KarlZeilhofer/htl-netzteil/screenshots/2019-12-21_009.png

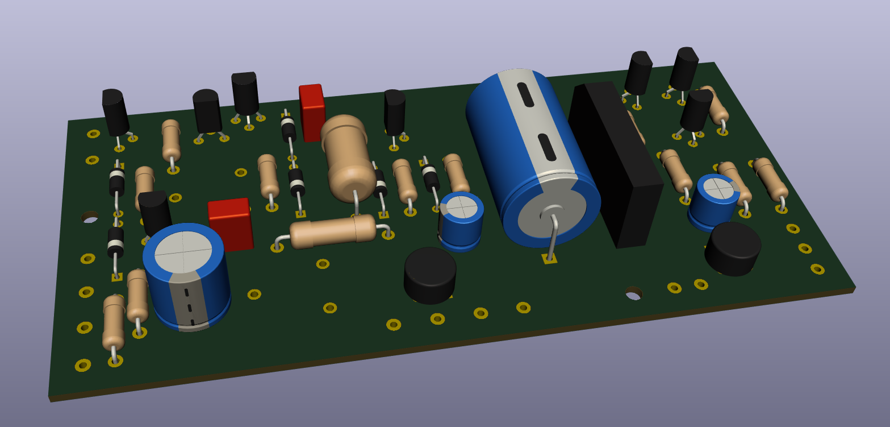
screenshots/2019-12-21_009.png
