KarlZeilhofer/htl-netzteil/screenshots/2019-12-21_006.png

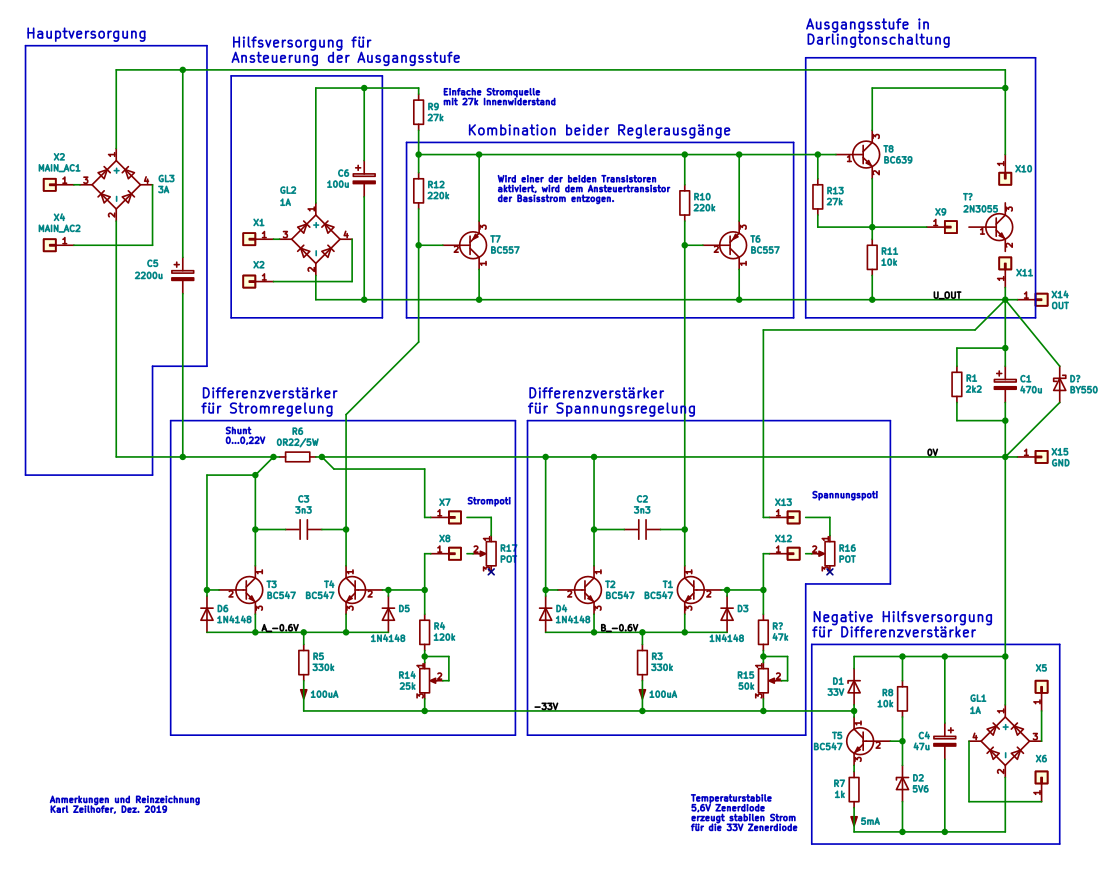
screenshots/2019-12-21_006.png
