KarlZeilhofer/htl-netzteil/screenshots/2019-12-21_007.png

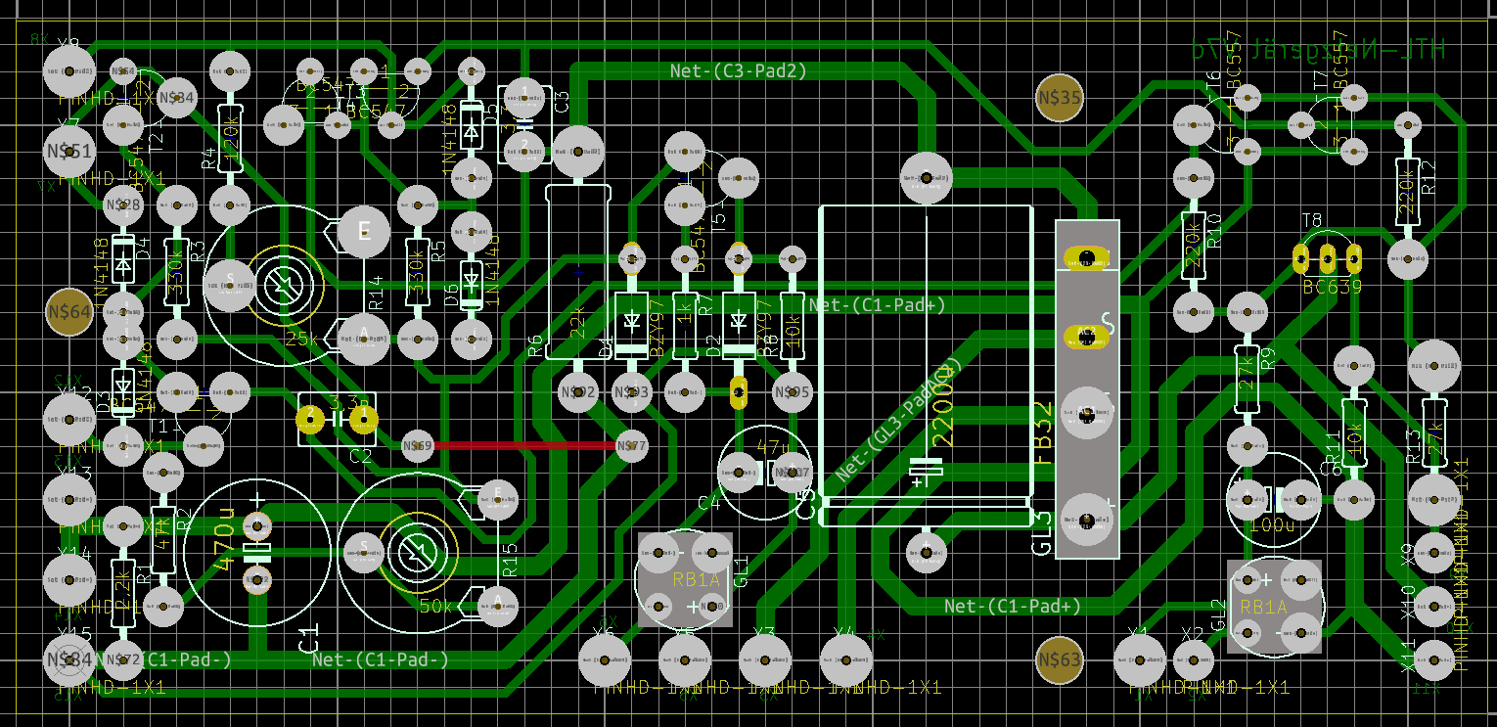
screenshots/2019-12-21_007.png
