KarlZeilhofer/htl-netzteil/screenshots/2019-12-21_010.png

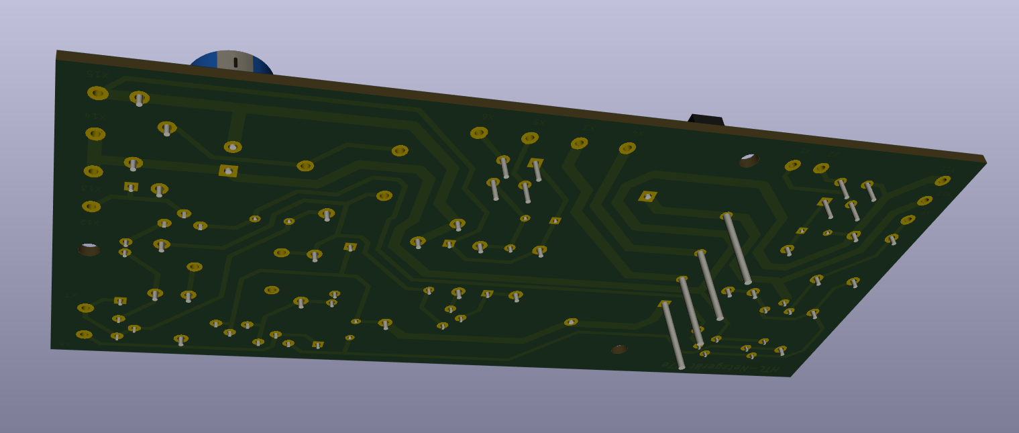
screenshots/2019-12-21_010.png
