KarlZeilhofer/htl-netzteil/screenshots/2019-12-21_011.png

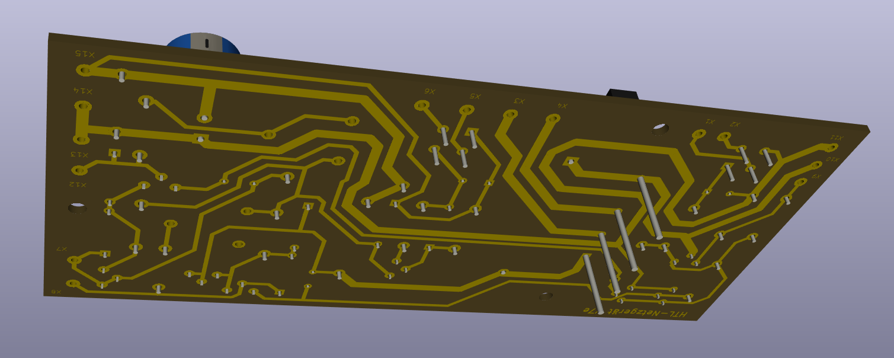
screenshots/2019-12-21_011.png
