KarlZeilhofer/htl-netzteil/screenshots/2020-11-19_003.png

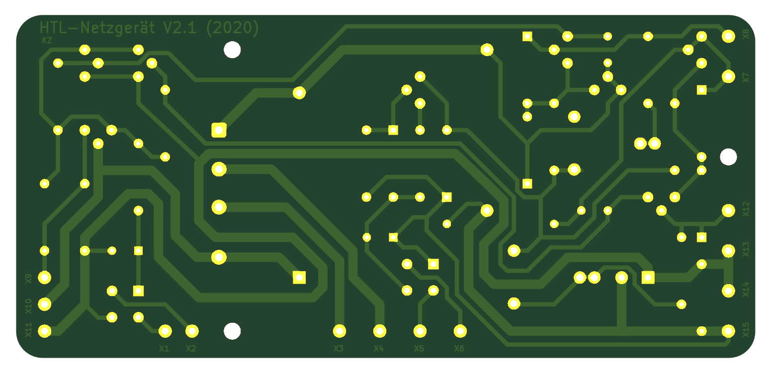
screenshots/2020-11-19_003.png
