KarlZeilhofer/htl-netzteil/screenshots/2020-11-19_005.png

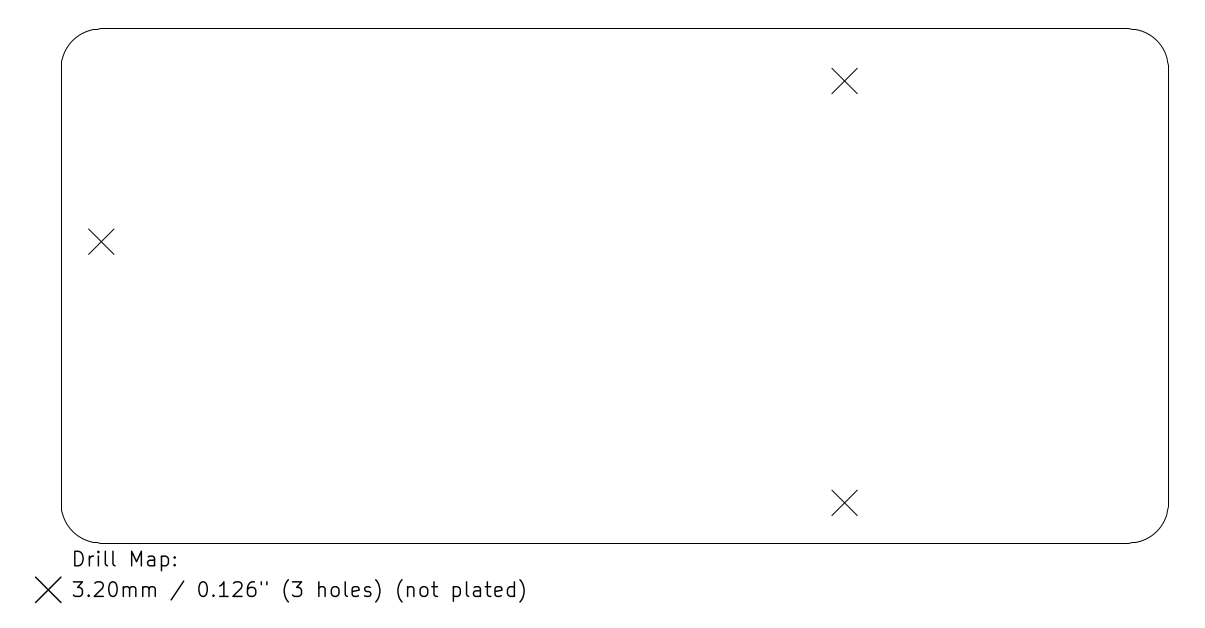
screenshots/2020-11-19_005.png
