KarlZeilhofer/htl-netzteil/screenshots/2020-11-19_006.png

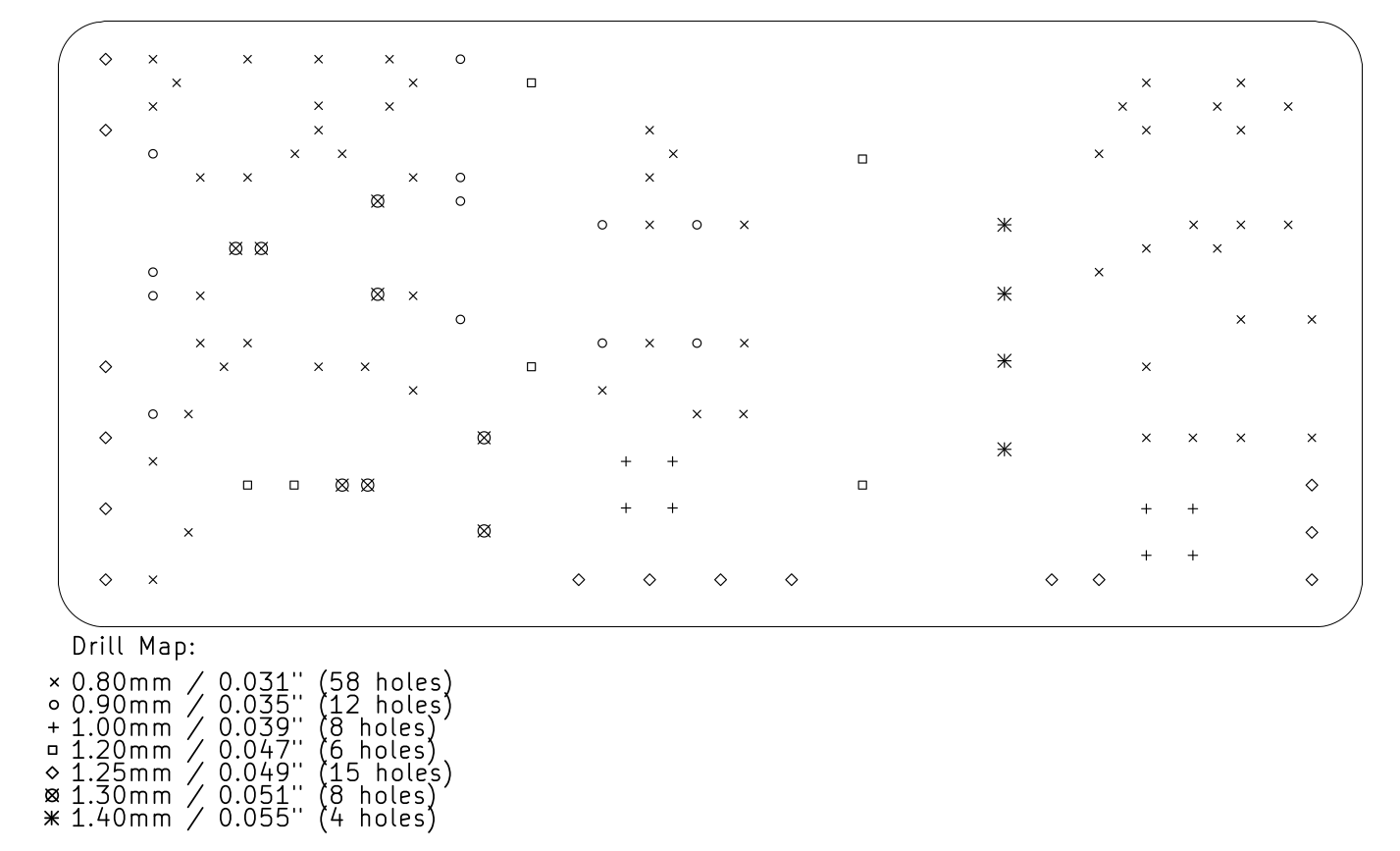
screenshots/2020-11-19_006.png
