KarlZeilhofer/htl-netzteil/screenshots/2020-11-19_007.png

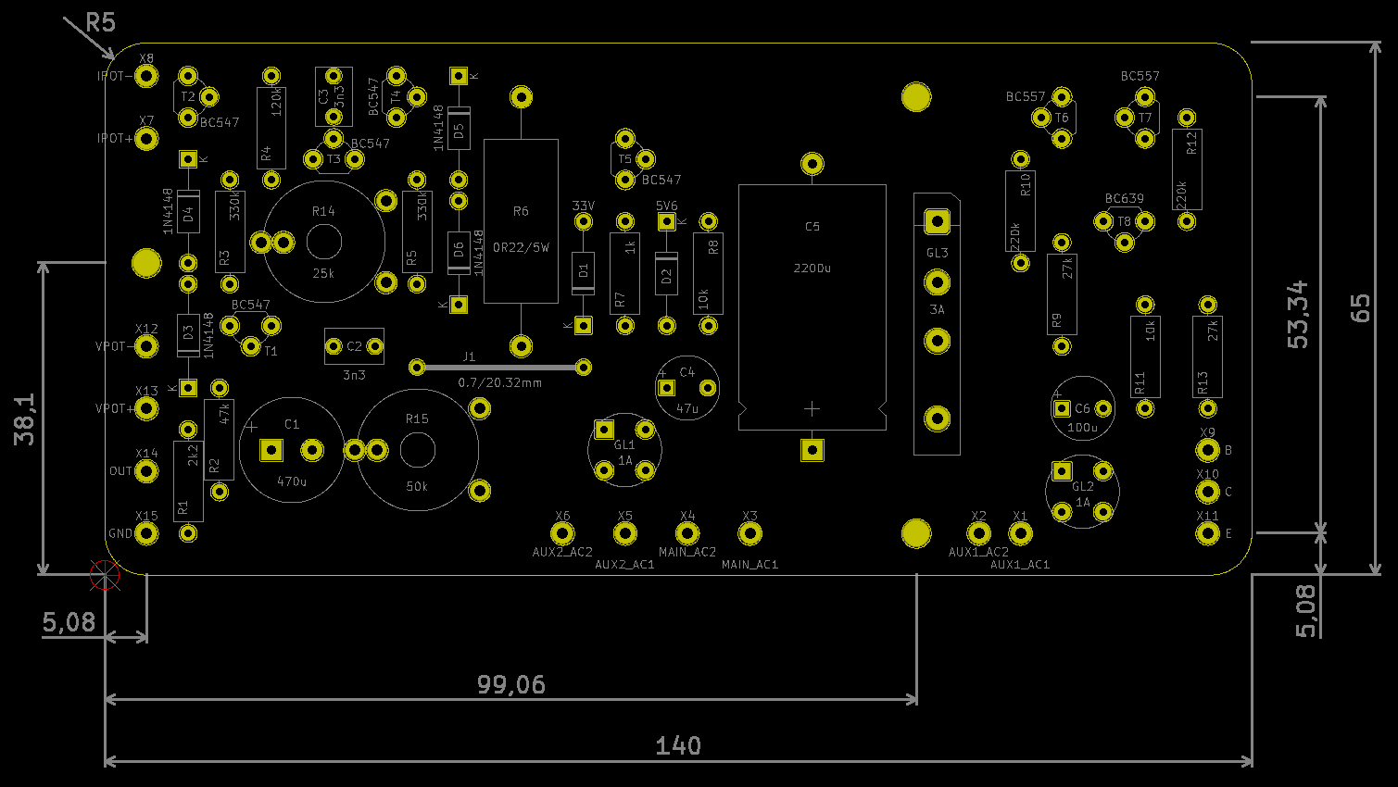
screenshots/2020-11-19_007.png
