KarlZeilhofer/htl-netzteil/screenshots/2020-11-19_008.png

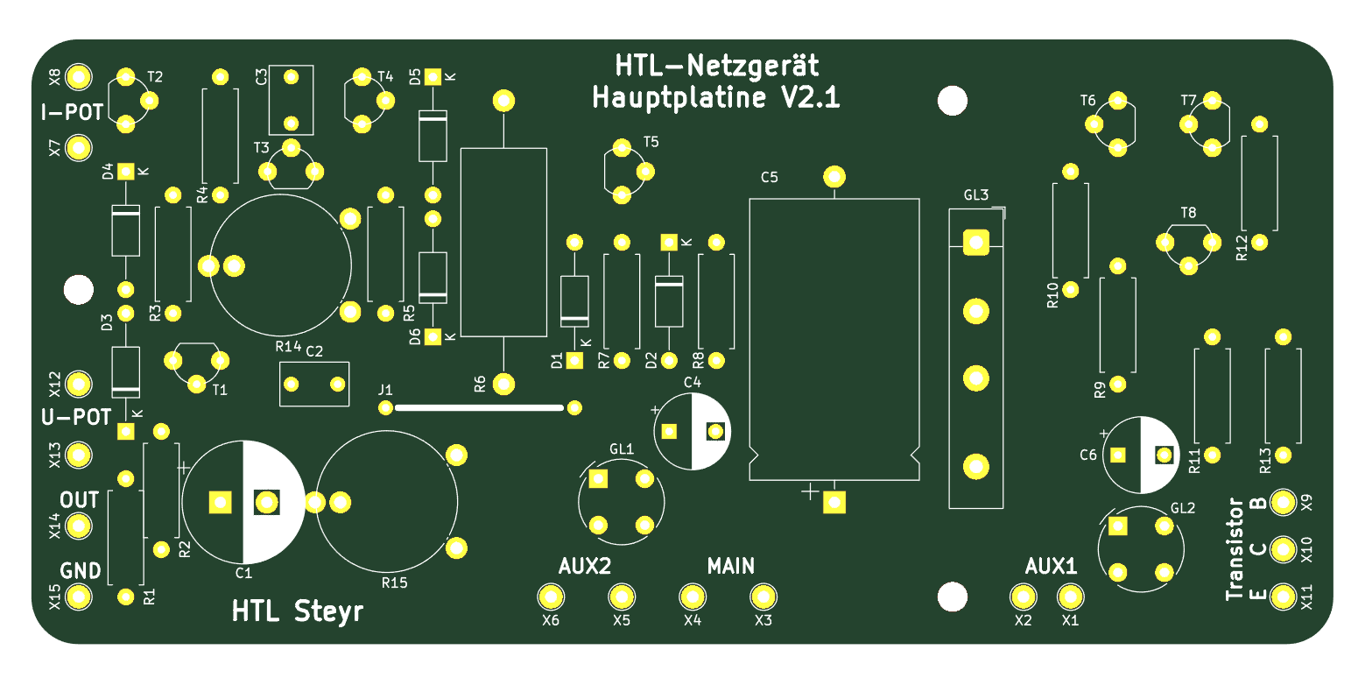
screenshots/2020-11-19_008.png
