KarlZeilhofer/htl-netzteil/screenshots/2020-11-19_010.png

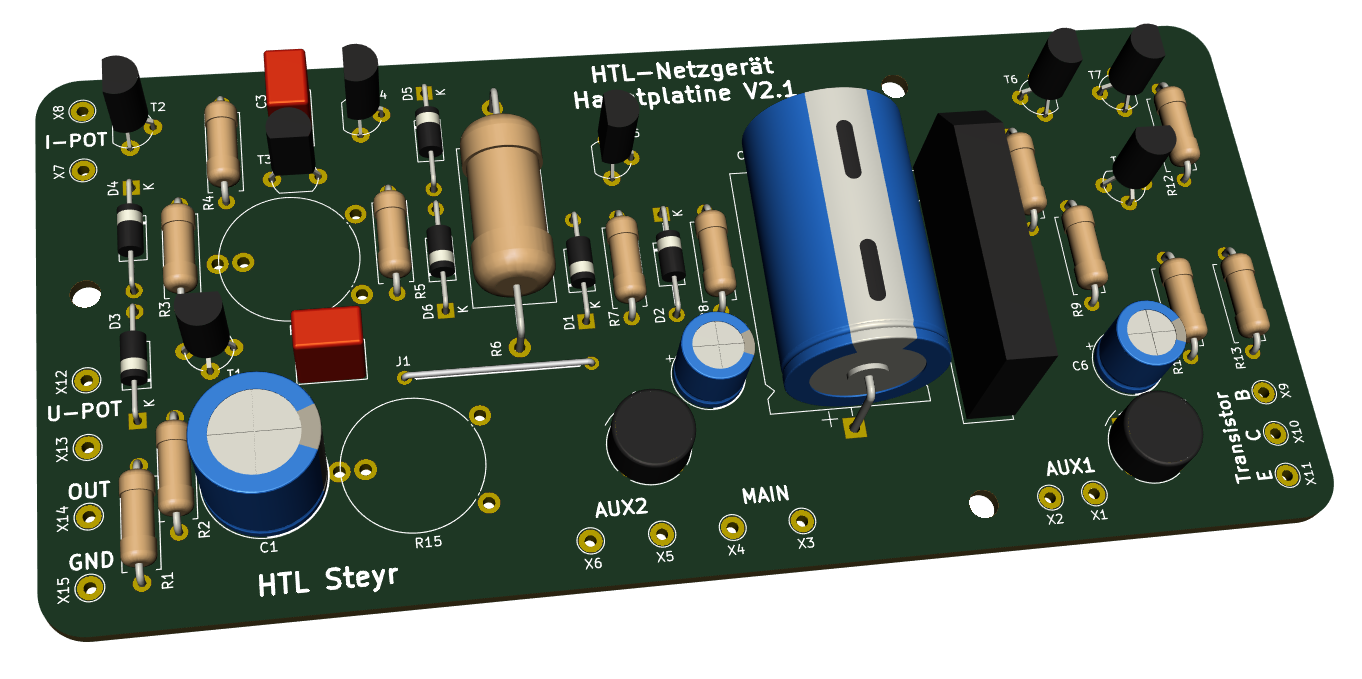
screenshots/2020-11-19_010.png
