KarlZeilhofer/htl-netzteil/screenshots/2020-11-20_001.png

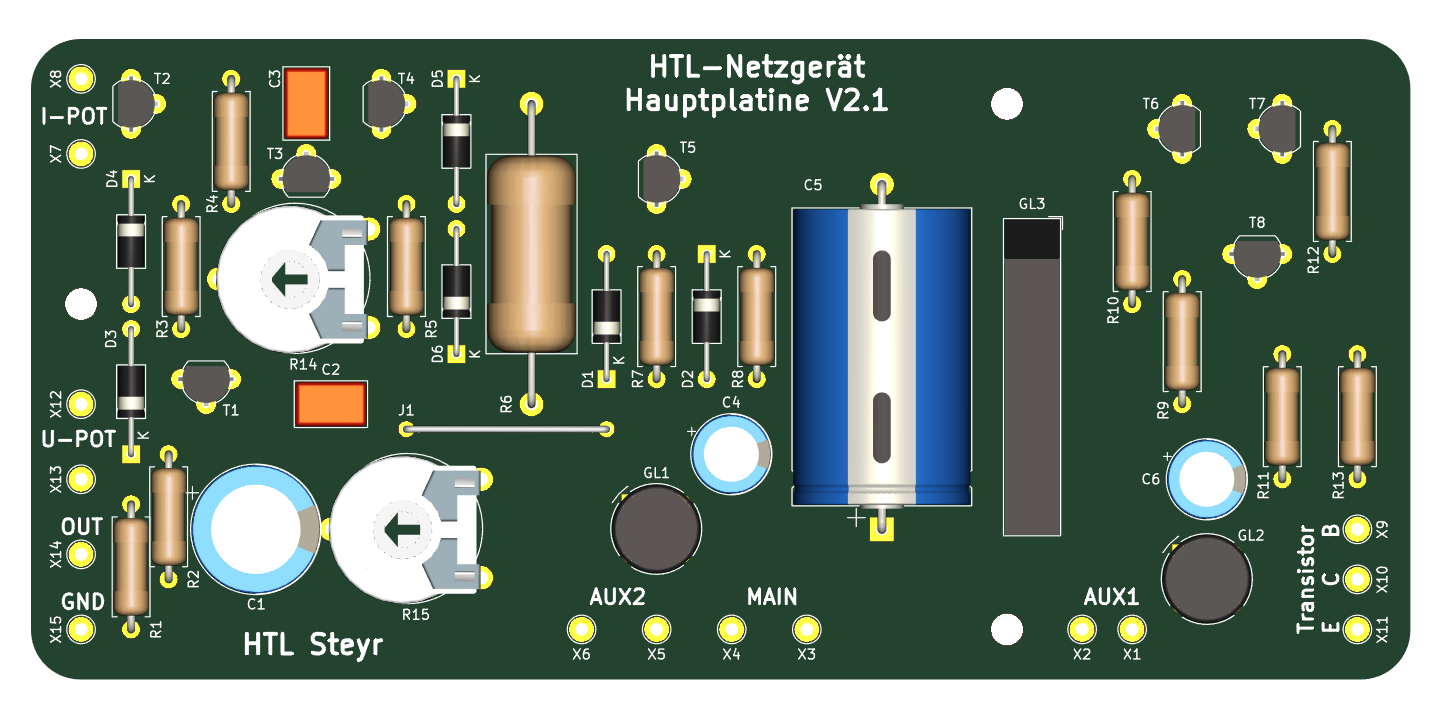
screenshots/2020-11-20_001.png
