KarlZeilhofer/htl-netzteil/sch/HTL Netzgerät bw.pdf

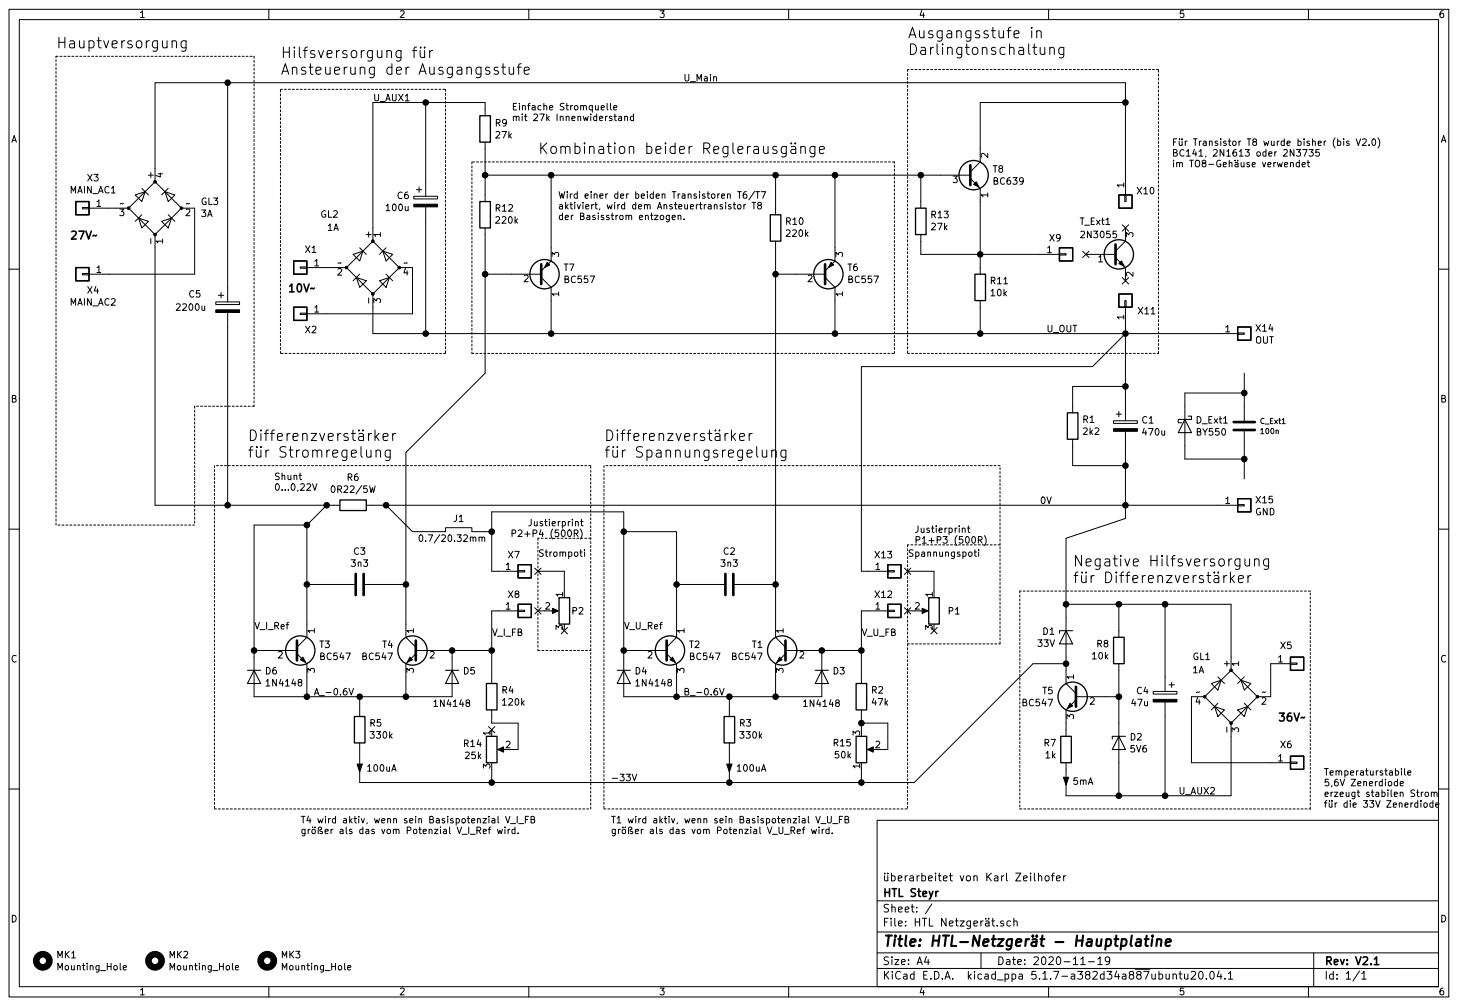
[picture p13: page 1]

Für Transistor T8 wurde bisher (bis V2.0) BC141, 2N1613 oder 2N3735

aktiviert, wird dem Ansteuertransistor T8
der Basisstrom entzogen.

Justierprint P2+P4 (500R)

Justierprint P1+P3 (500R)

T4 wird aktiv, wenn sein Basispotenzial V_I_FB
größer als das vom Potenzial V_I_Ref wird.

T1 wird aktiv, wenn sein Basispotenzial V_U_FB
größer als das vom Potenzial V_U_Ref wird.

Id: 1/1 Title: HTL-Netzgerät - Hauptplatine
