KarlZeilhofer/htl-netzteil/fab/HTL Netzgerät-F_Fab.pdf

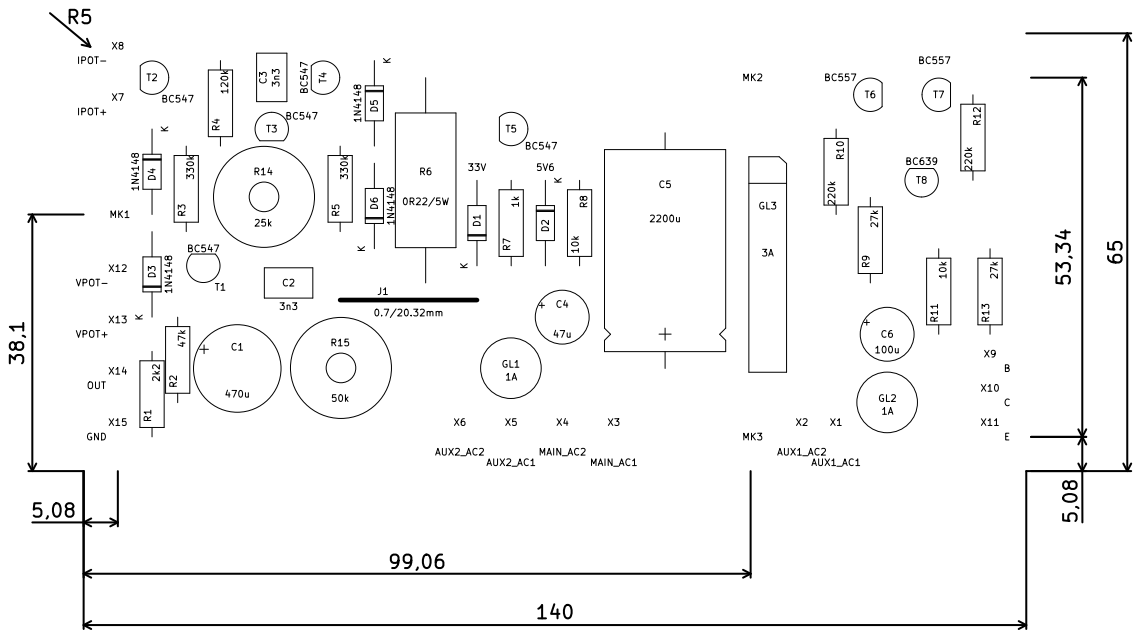
[picture p14: page 1]
