KarlZeilhofer/htl-netzteil/HTL Netzgerät.kicad_pcb

## KiCad design HTL Netzgerät.kicad_pcb (2021-04-29)

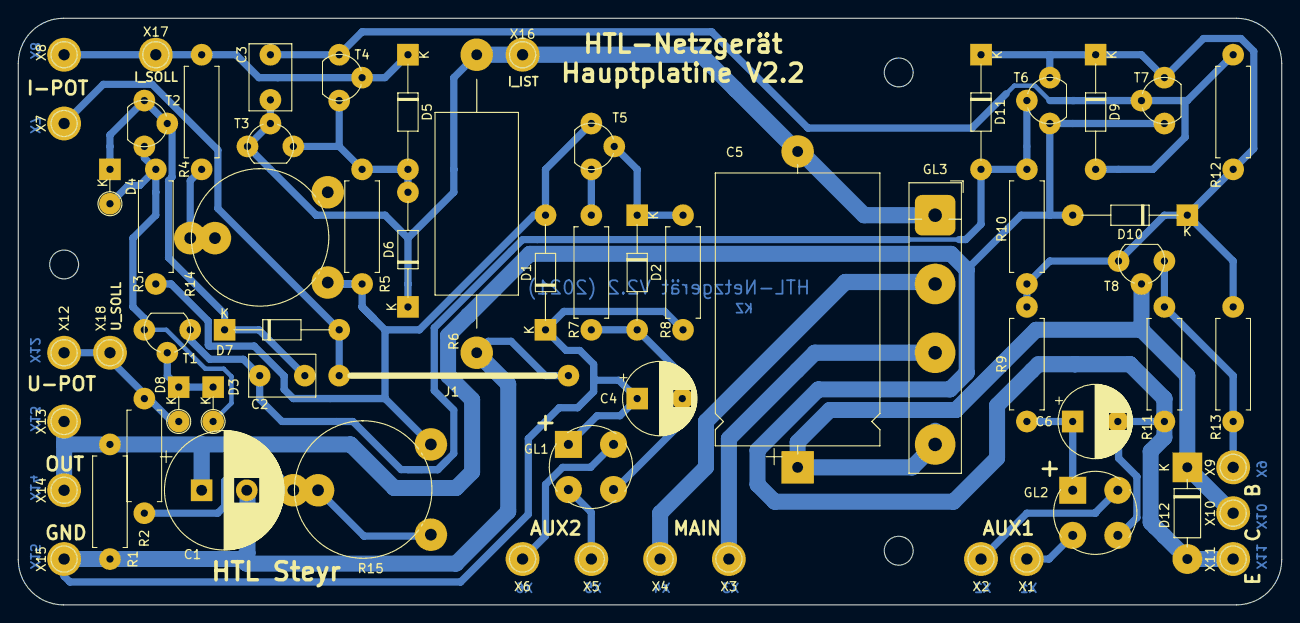
[picture p15: board HTL Netzgerät.kicad_pcb from above]

Board: 2 copper layers, 140.0 x 65.0 mm, 66 parts (0 on the bottom side), 28 nets.

Parts:
C1: 470u; CP_Radial_D13.0mm_P5.00mm
C2, C3: 3n3; C_Rect_L7.2mm_W4.5mm_P5.00mm_FKS2_FKP2_MKS2_MKP2
C4: 47u; CP_Radial_D8.0mm_P5.00mm
C5: 2200u; CP_Axial_L30.0mm_D18.0mm_P35.00mm_Horizontal
C6: 100u; CP_Radial_D8.0mm_P5.00mm
D1: 33V; D_DO-35_SOD27_P12.70mm_Horizontal
D2: 5V6; D_DO-35_SOD27_P12.70mm_Horizontal
D3, D4, D8: 1N4148; D_DO-35_SOD27_P3.81mm_Vertical_KathodeUp
D5, D6, D7, D9, D10, D11: 1N4148; D_DO-35_SOD27_P12.70mm_Horizontal
D12: 1N4007; D_DO-41_SOD81_P10.16mm_Horizontal
GL1, GL2: 1A; Diode_Bridge_Round_D9.0mm
GL3: 3A; Brueckengleichrichter_p7.4-7.2-9.5mm
J1: 0.7/25.4mm; Drahtbruecke_d0.7mm_P20.32mm
MK1, MK2, MK3: Mounting_Hole; MountingHole_3.2mm_M3
R1: 2k2; R_Axial_DIN0411_L9.9mm_D3.6mm_P12.70mm_Horizontal
R2: 47k; R_Axial_DIN0411_L9.9mm_D3.6mm_P12.70mm_Horizontal
R3, R5: 330k; R_Axial_DIN0411_L9.9mm_D3.6mm_P12.70mm_Horizontal
R4: 120k; R_Axial_DIN0411_L9.9mm_D3.6mm_P12.70mm_Horizontal
R6: 0R22/5W; R_Axial_DIN0922_L20.0mm_D9.0mm_P30.48mm_Horizontal
R7: 1k; R_Axial_DIN0411_L9.9mm_D3.6mm_P12.70mm_Horizontal
R8, R11: 10k; R_Axial_DIN0411_L9.9mm_D3.6mm_P12.70mm_Horizontal
R9, R13: 27k; R_Axial_DIN0411_L9.9mm_D3.6mm_P12.70mm_Horizontal
R10, R12: 220k; R_Axial_DIN0411_L9.9mm_D3.6mm_P12.70mm_Horizontal
R14: 25k; Potentiometer_Piher_PT-15-V02_Vertical
R15: 50k; Potentiometer_Piher_PT-15-V02_Vertical
T1, T2, T3, T4, T5: BC547; TO-92
T6, T7: BC557; TO-92
T8: BC639; TO-92
X1: AUX1_AC1; Einpress-Stift_Drill1.25mm
X2: AUX1_AC2; Einpress-Stift_Drill1.25mm
X3: MAIN_AC1; Einpress-Stift_Drill1.25mm
X4: MAIN_AC2; Einpress-Stift_Drill1.25mm
X5: AUX2_AC1; Einpress-Stift_Drill1.25mm
X6: AUX2_AC2; Einpress-Stift_Drill1.25mm
X7, X16, X17, X18: IPOT+; Einpress-Stift_Drill1.25mm
X8: IPOT-; Einpress-Stift_Drill1.25mm
X9: B; Einpress-Stift_Drill1.25mm
X10: C; Einpress-Stift_Drill1.25mm
X11: E; Einpress-Stift_Drill1.25mm
X12: VPOT-; Einpress-Stift_Drill1.25mm
X13: VPOT+; Einpress-Stift_Drill1.25mm
X14: OUT; Einpress-Stift_Drill1.25mm
X15: GND; Einpress-Stift_Drill1.25mm

Connections:
/0V: C1.2, C4.1, D1.1, GL1.1, J1.1, R1.1, R6.2, R8.2, X15.1
/-33V: D1.2, R3.1, R5.1, R14.3, R15.1, T5.1
/A_-0.6V: D5.2, D6.2, R5.2, T3.3, T4.3
/B_-1.2V: D3.2, D4.2, R3.2, T1.3, T2.3
/U_AUX1: C6.1, GL2.1, R9.1
/U_AUX2: C4.2, D2.2, GL1.3, R7.1
/U_Main: C5.1, D12.1, GL3.4, T8.2, X10.1
/U_OUT: C1.1, C6.2, D10.2, D12.2, GL2.3, R1.2, R11.1, T6.1, T7.1, X11.1, X13.1, X14.1
/V_I_FB: D5.1, R4.2, T4.2, X8.1, X17.1
/V_I_Ref: C3.2, C5.2, D6.1, GL3.1, R6.1, T3.1, T3.2, X16.1
/V_U_FB: D8.2, R2.2, X12.1, X18.1
/V_U_Ref: C2.2, D4.1, D7.1, T2.1, T2.2
unnamed: C2.1, D11.2, R10.1, T1.1, T6.2
unnamed: C3.1, D9.2, R12.1, T4.1, T7.2
unnamed: D2.1, R8.1, T5.2
unnamed: D3.1, D8.1, T1.2
unnamed: D7.2, J1.2, X7.1
unnamed: D9.1, D10.1, D11.1, R9.2, R10.2, R12.2, R13.2, T6.3, T7.3, T8.3
unnamed: GL1.2, X5.1
unnamed: GL1.4, X6.1
unnamed: GL2.2, X1.1
unnamed: GL2.4, X2.1
unnamed: GL3.2, X4.1
unnamed: GL3.3, X3.1
unnamed: R7.2, T5.3
unnamed: R11.2, R13.1, T8.1, X9.1
unnamed: R4.1, R14.2
unnamed: R2.1, R15.2, R15.3
