KarlZeilhofer/htl-netzteil/(threads)

Thread 10 (2021-05-19):

Haupttransistor Beschriftung

KarlZeilhofer, 2021-05-19:
Muss korrigiert werden!

KarlZeilhofer, 2021-08-30:
Hier konnte nun kein Fehler in V2.2 entdeckt werden...

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

Auch die Durchnummerierung X9, X10, X11 passt zur Dokumentation (Verdrahtungsschema) zusammen.

Closed 2021-08-30.
