KarlZeilhofer/htl-netzteil/(commit log)

2019-12-21 Version 7d, übernommen von EGLG
    [HTL Netzgerät V7d.kicad_pcb, HTL Netzgerät V7d.sch]
2019-12-21 nun mit Reinzeichnung und Kommentaren von mir
    [reinzeichnung.sch]
2019-12-21 Reinzeichnung ins Hauptdokument verschoben, Hauptdokument gelöscht
    [HTL Netzgerät V7d.sch, reinzeichnung.sch]
2019-12-21 neue footprints zugeordnet im Schaltplan
    [HTL Netzgerät V7d.sch]
2019-12-21 Layout soweit fertig, Changelog angepasst, siehe TODOs, eMail an Kollegen
    [HTL Netzgerät V7d.kicad_pcb, HTL Netzgerät V7d.sch, HTL Netzgerät.kicad_pcb, HTL Netzgerät.sch]
2020-11-16 Libs und TODOs aktualisiert
    [HTL Netzgerät.kicad_pcb, HTL Netzgerät.sch]
2020-11-18 Einige Korrekturen eingepflegt für Version 2.1
    [HTL Netzgerät.kicad_pcb, HTL Netzgerät.sch]
2020-11-19 Weitere Verbesserungen, Drahtbrücke, Texte, siehe Changelog
    [HTL Netzgerät.kicad_pcb, HTL Netzgerät.sch]
2020-11-19 Fertig zur Produktion, Gerber, Screenshots, Bestückungsdruck, ...
    [HTL Netzgerät-B_Mask.gbr, HTL Netzgerät-Bottom.gbr, HTL Netzgerät-Edge_Cuts.gbr, HTL Netzgerät-F_Mask.gbr, HTL Netzgerät-F_SilkS.gbr, HTL Netzgerät-NPTH.drl, HTL Netzgerät-PTH.drl, HTL Netzgerät-Top.gbr]
2020-11-20 3D Modell für Trimmer inkl. Screenshot
    [HTL Netzgerät.kicad_pcb]
2021-04-29 v2.2 fertig, 3 Stk. bestellt (einseitig)
    siehe CHANGELOG und Github Issues
    [HTL Netzgerät-B_Mask.gbr, HTL Netzgerät-Bottom.gbr, HTL Netzgerät-Edge_Cuts.gbr, HTL Netzgerät-F_Mask.gbr, HTL Netzgerät-F_SilkS.gbr, HTL Netzgerät-NPTH.drl, HTL Netzgerät-PTH.drl, HTL Netzgerät-Top.gbr]
